64qyt6za/GSGSmartiecar/schematics/ReadMe.md

This directory contains schematics of the chassis and the electronics.
