64qyt6za/GSGSmartiecar/src/py/images/README.md

## Image description

## Frame image
the first image called frame.jpg is the normal raw version without anything uncut and unedited.

## Cropped image
the second image called cropped.jpg is the cropped version of the image. This image is cropped to the size of the frame of the image. This is done to remove the black borders around the image.
