64qyt6za/GSGSmartiecar/Carphotos/Below.jpg

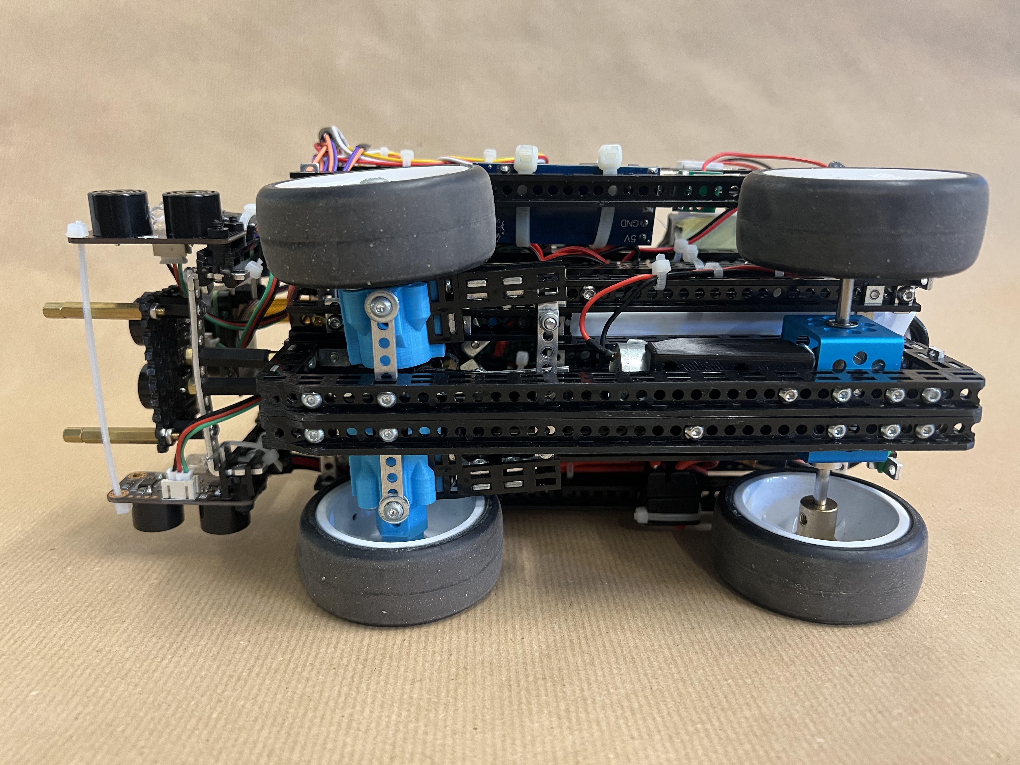
Carphotos/Below.jpg
