64qyt6za/GSGSmartiecar/Carphotos/Detailphotos/All-levels.jpg

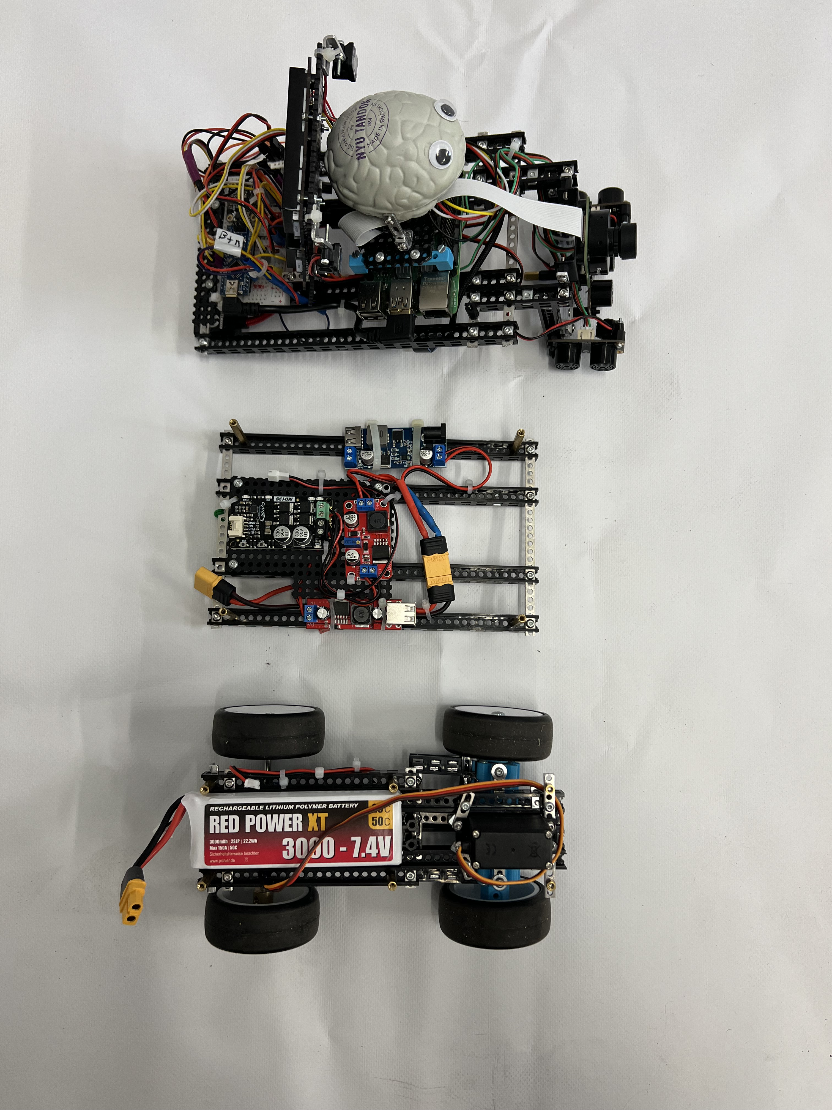
Carphotos/Detailphotos/All-levels.jpg
