64qyt6za/GSGSmartiecar/Carphotos/Detailphotos/First-level.jpg

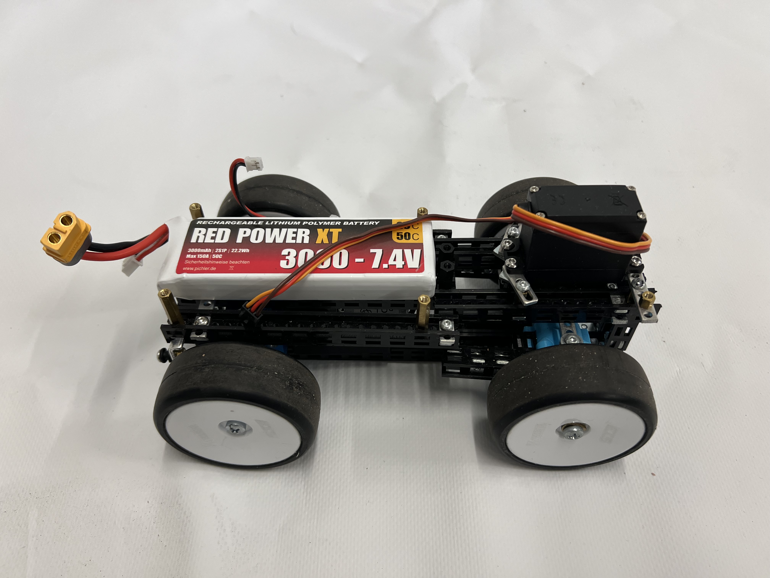
Carphotos/Detailphotos/First-level.jpg
