64qyt6za/GSGSmartiecar/Carphotos/Detailphotos/IMG_7283.jpeg

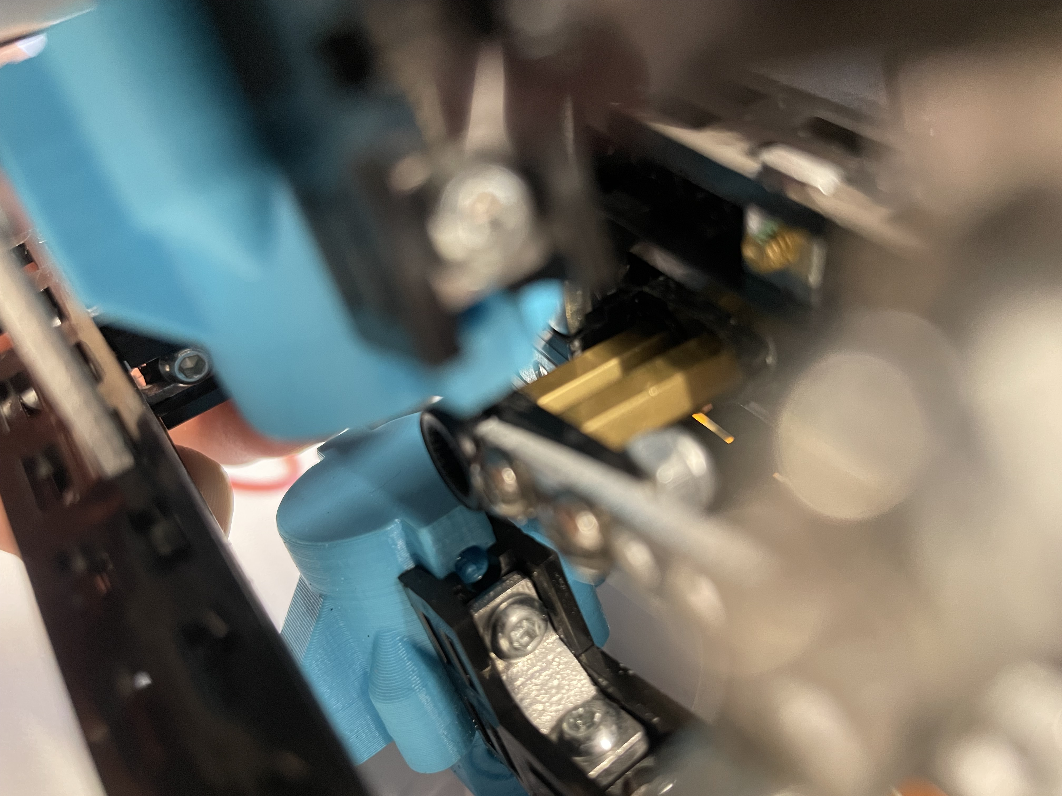
Carphotos/Detailphotos/IMG_7283.jpeg
