64qyt6za/GSGSmartiecar/Carphotos/Detailphotos/Second-level.jpg

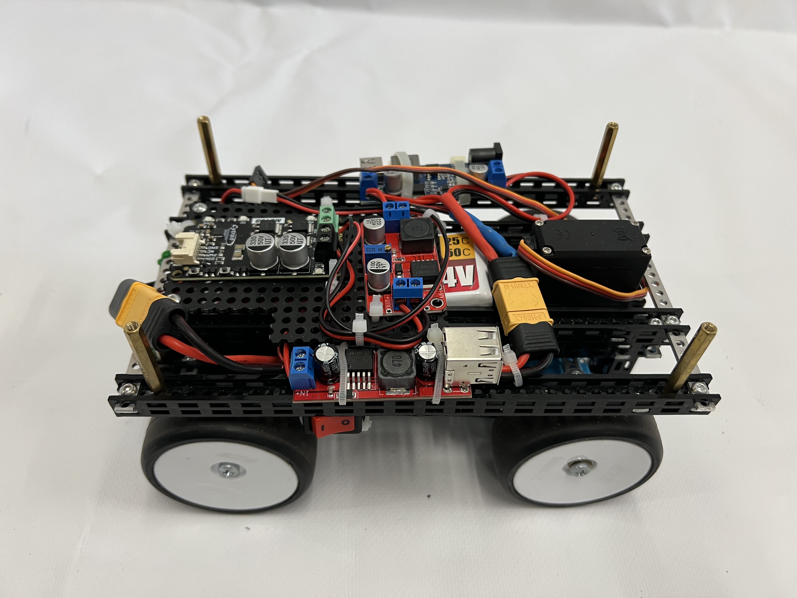
Carphotos/Detailphotos/Second-level.jpg
