64qyt6za/GSGSmartiecar/Carphotos/Detailphotos/Third-level.jpg

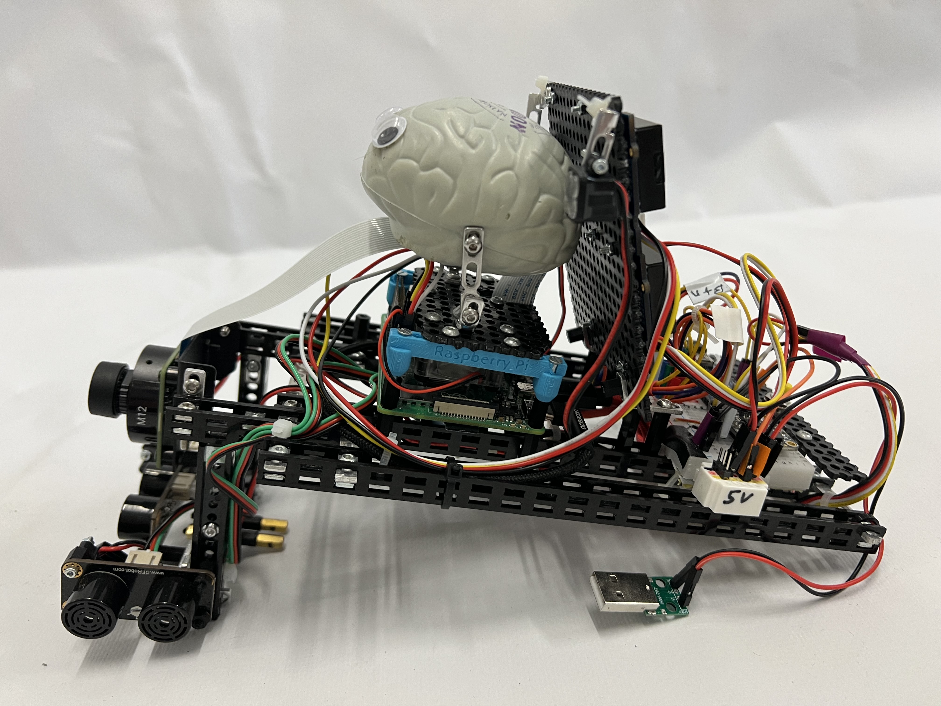
Carphotos/Detailphotos/Third-level.jpg
