64qyt6za/GSGSmartiecar/Carphotos/Detailphotos/Transmisson.jpg

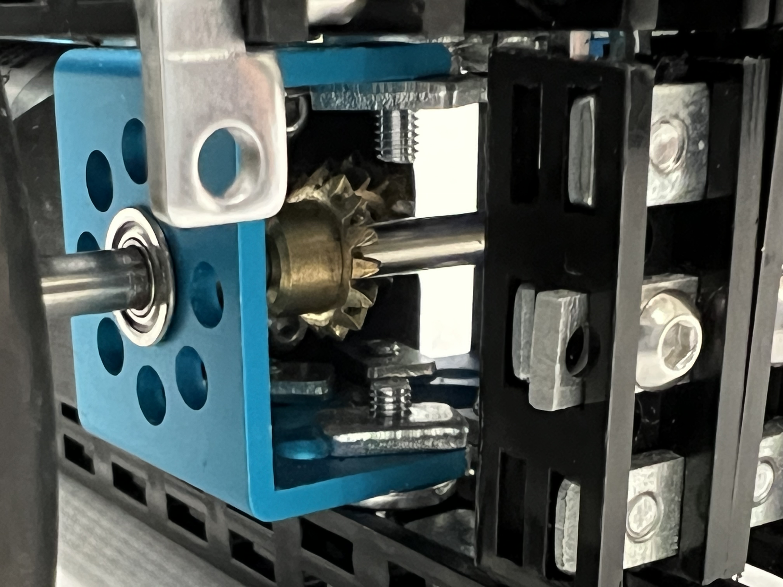
Carphotos/Detailphotos/Transmisson.jpg
