64qyt6za/GSGSmartiecar/schematics/Blockdiagram_layers.png

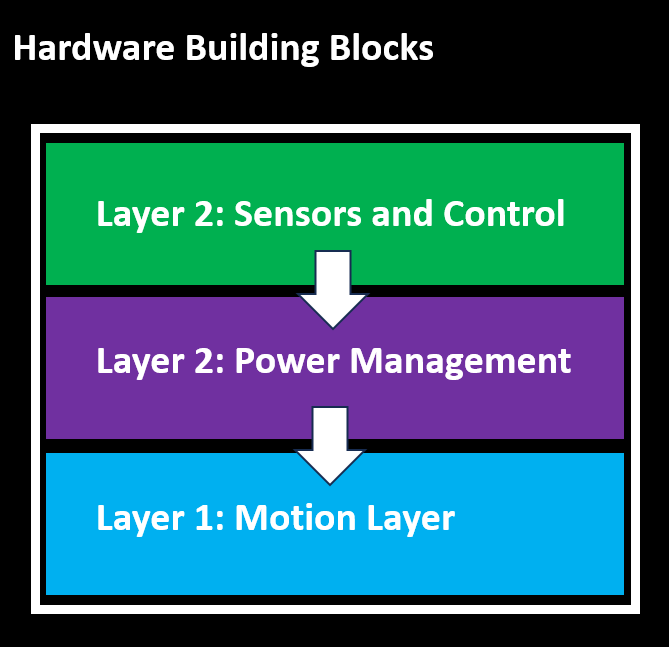
schematics/Blockdiagram_layers.png
