64qyt6za/GSGSmartiecar/schematics/blockdiagram_software.png

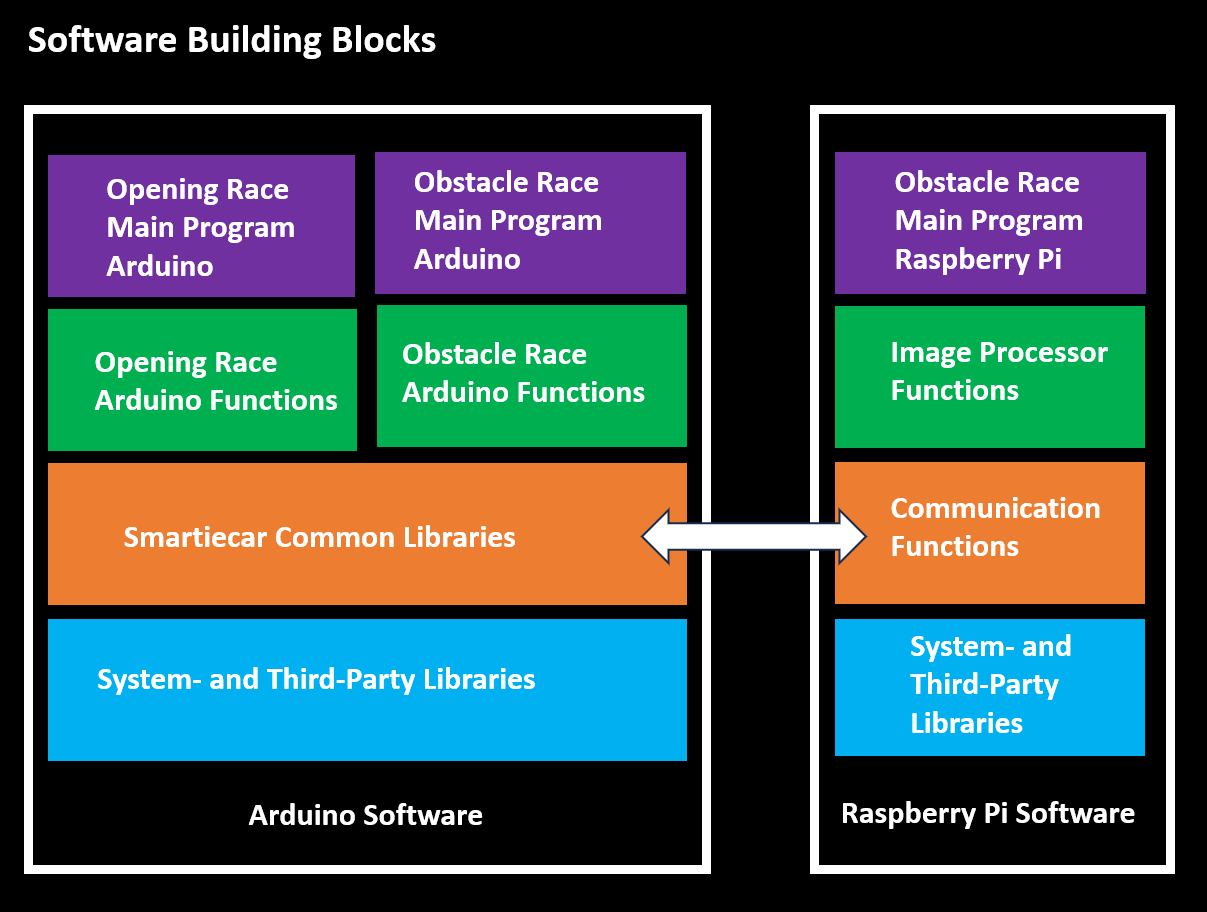
schematics/blockdiagram_software.png
