64qyt6za/GSGSmartiecar/schematics/circuit diagram3.jpg

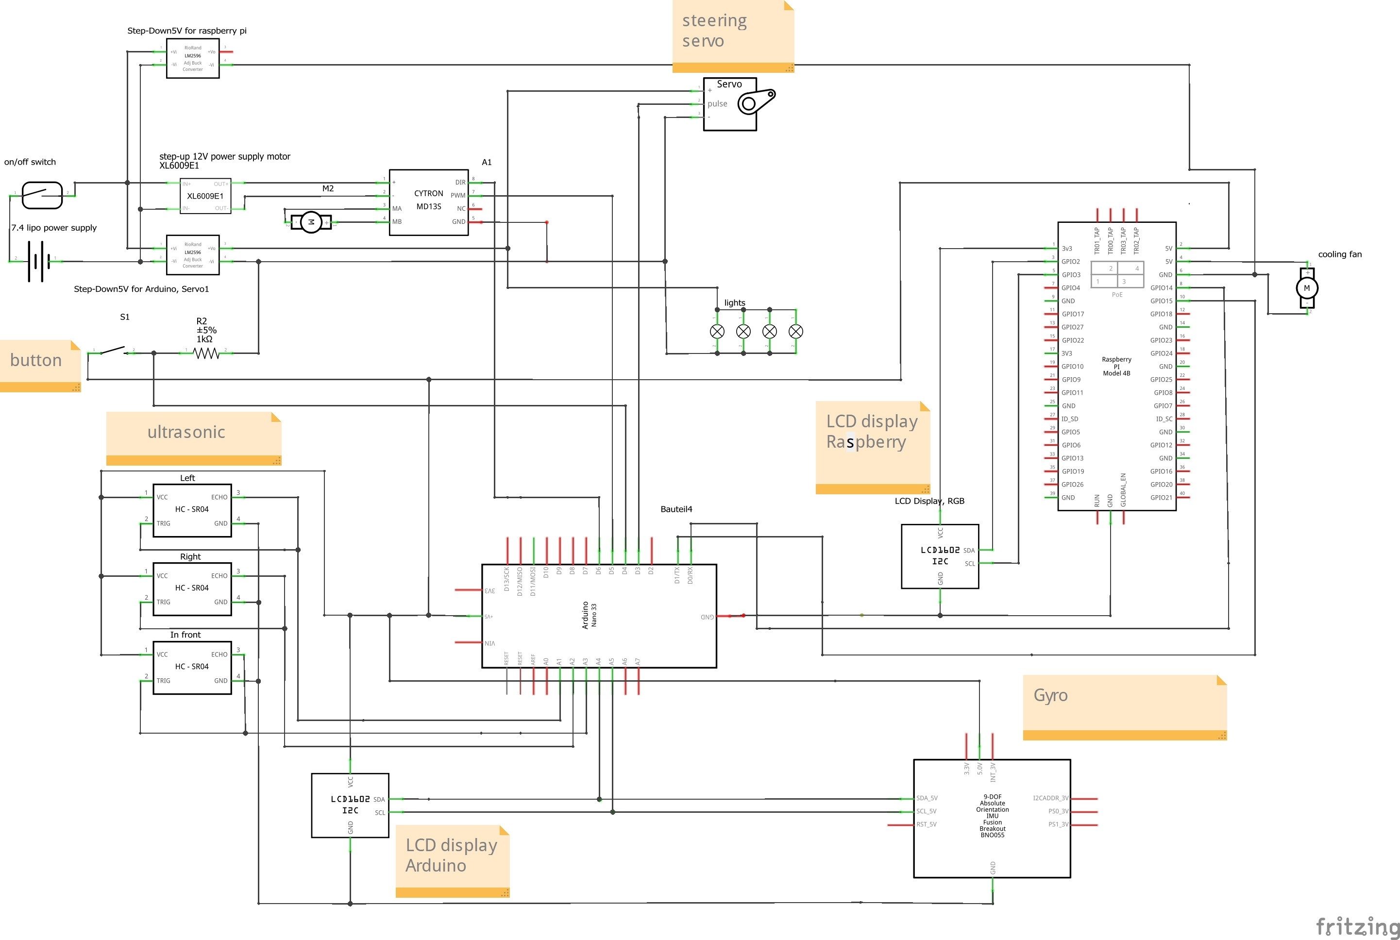
schematics/circuit diagram3.jpg
