64qyt6za/GSGSmartiecar/schematics/Layer 1 Side.png

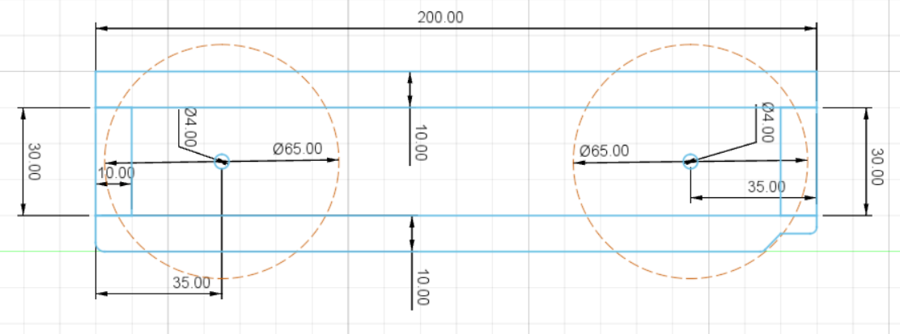
schematics/Layer 1 Side.png
