64qyt6za/GSGSmartiecar/schematics/Layer 1 Top.png

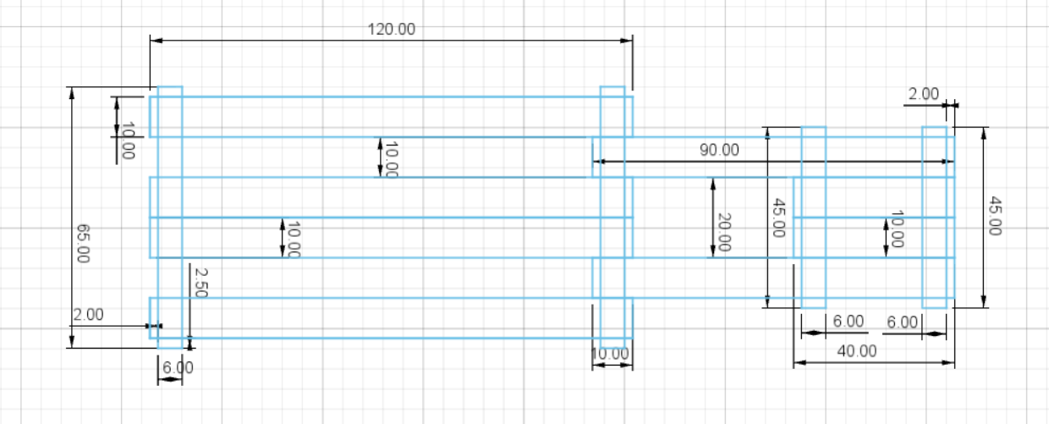
schematics/Layer 1 Top.png
