64qyt6za/GSGSmartiecar/schematics/Layer 2.png

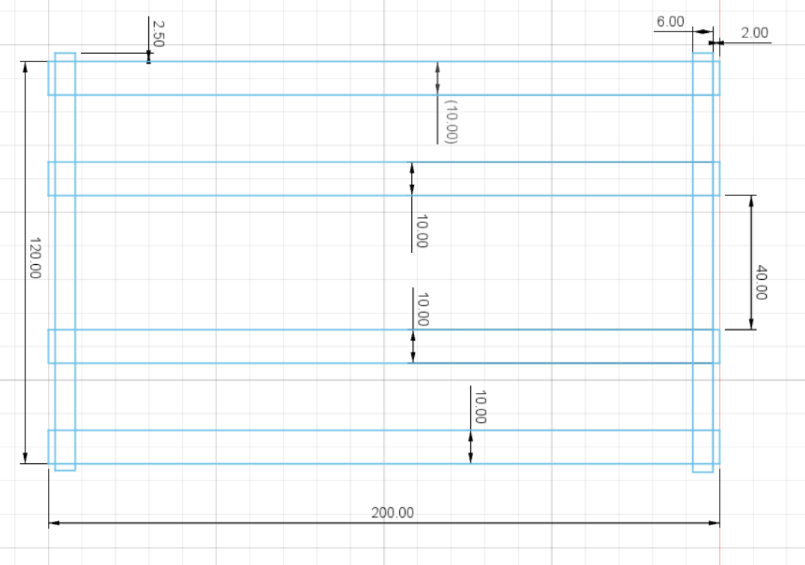
schematics/Layer 2.png
