64qyt6za/GSGSmartiecar/schematics/Layer 3 .png

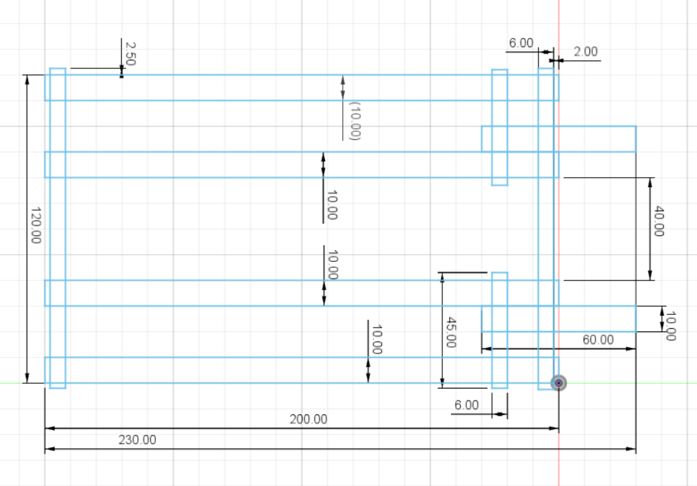
schematics/Layer 3 .png
