64qyt6za/GSGSmartiecar/src/ino/flow charts/Diagram_obstacle_init_phase.jpg

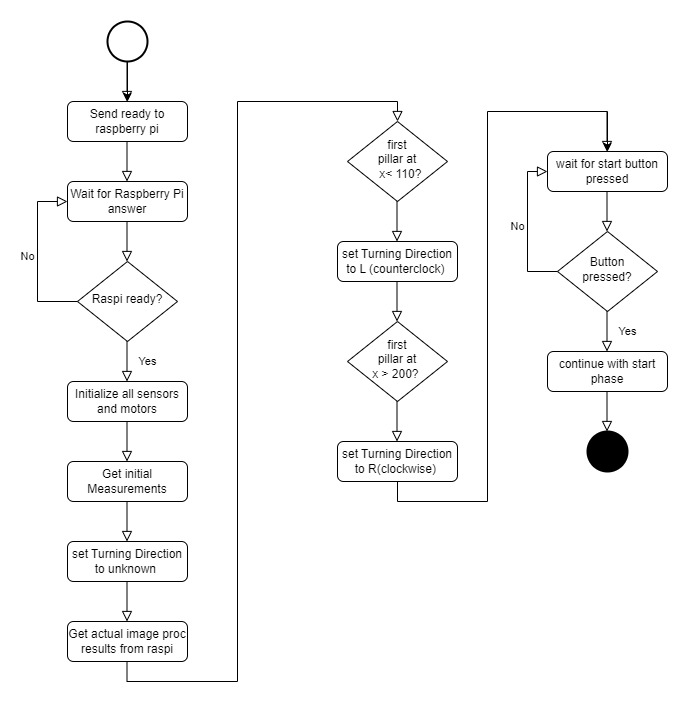
src/ino/flow charts/Diagram_obstacle_init_phase.jpg
