64qyt6za/GSGSmartiecar/src/ino/flow charts/Diagram_open_end_phase.jpg

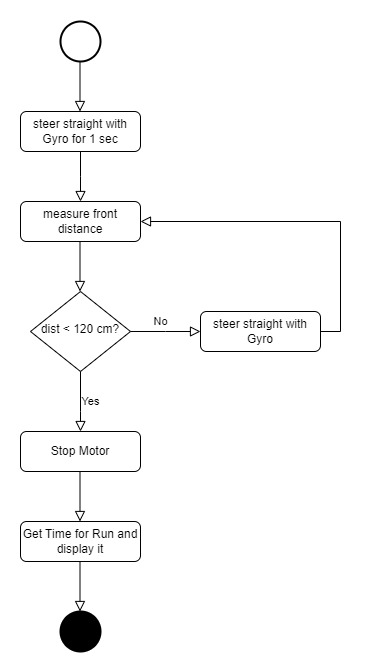
src/ino/flow charts/Diagram_open_end_phase.jpg
