64qyt6za/GSGSmartiecar/src/ino/flow charts/Diagram_open_phases.jpg

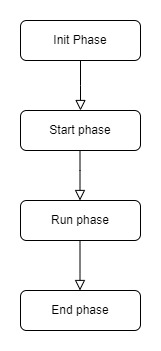
src/ino/flow charts/Diagram_open_phases.jpg
