64qyt6za/GSGSmartiecar/src/ino/flow charts/Diagram_open_start_phase.jpg

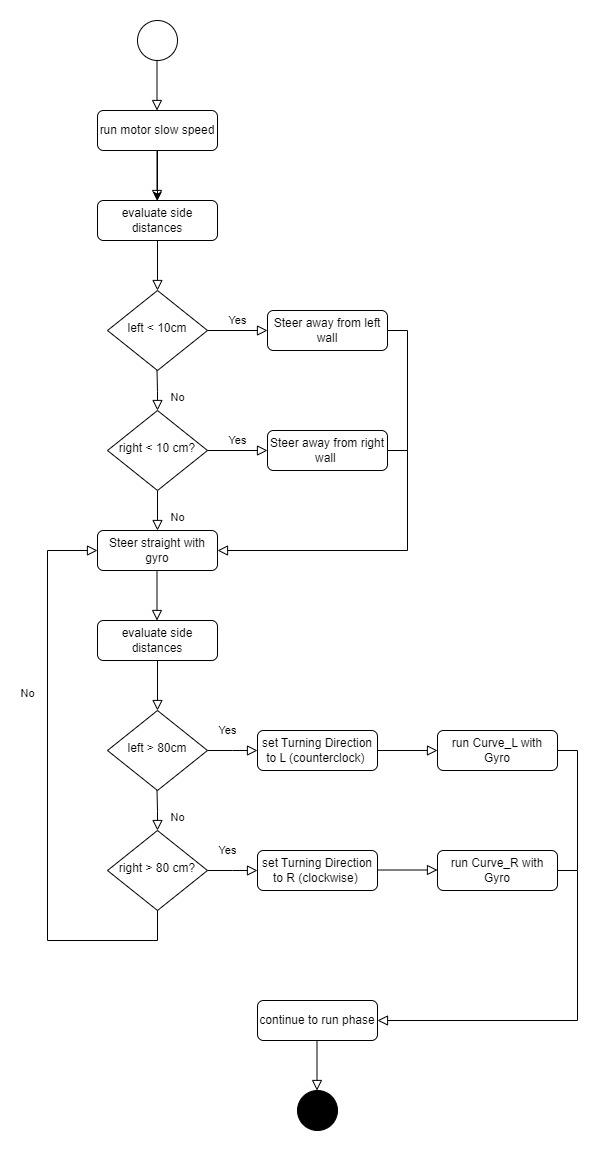
src/ino/flow charts/Diagram_open_start_phase.jpg
