64qyt6za/GSGSmartiecar/src/ino/flow charts/pillar_detector.jpg

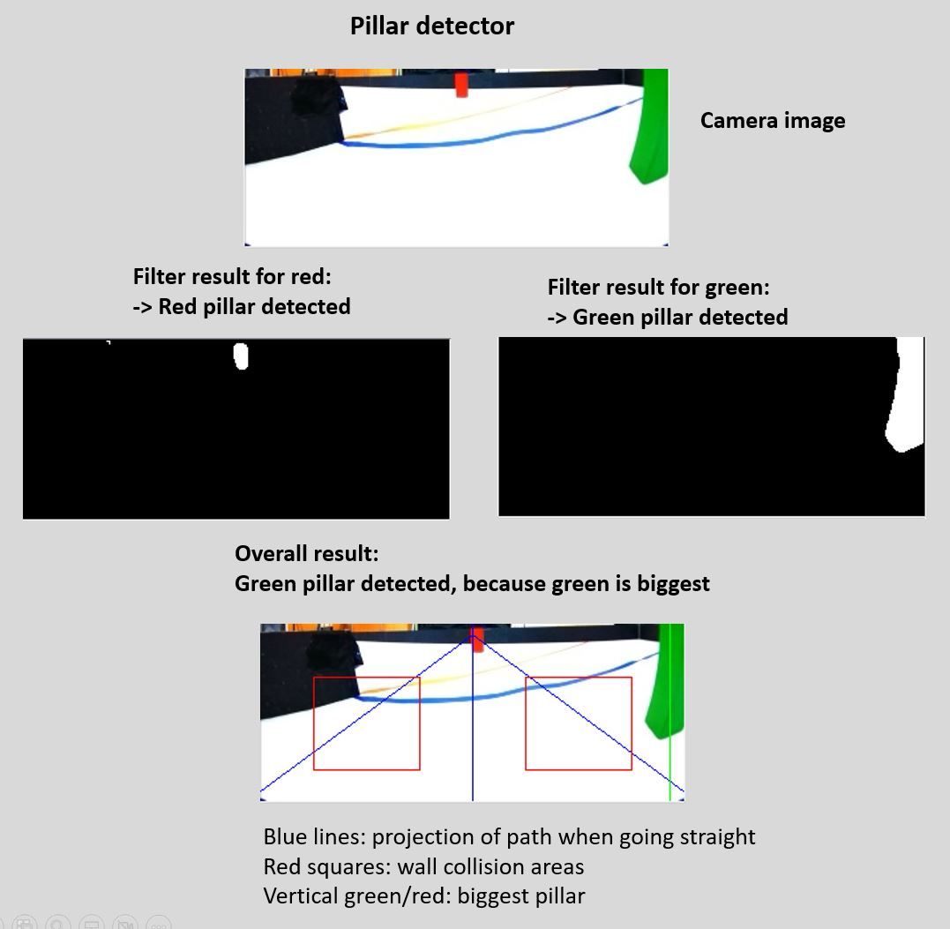
src/ino/flow charts/pillar_detector.jpg
