64qyt6za/GSGSmartiecar/src/ino/flow charts/Raspberry_Pi_detect_pillars.jpg

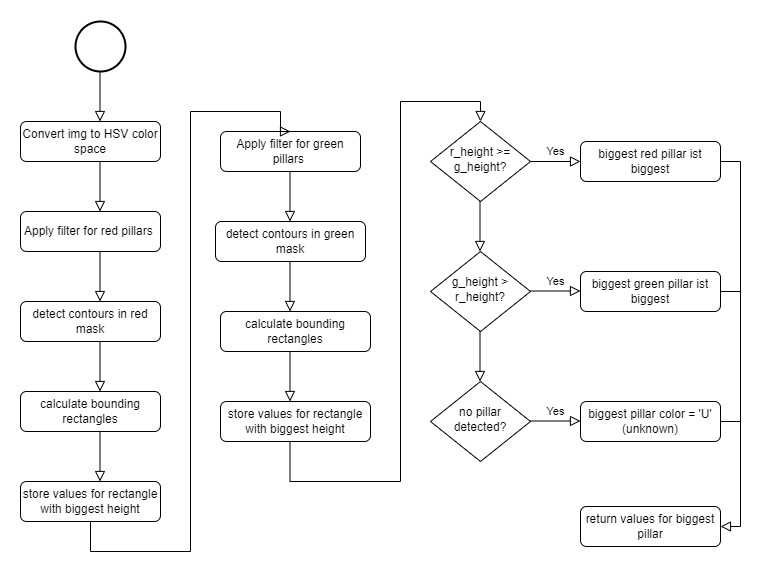
src/ino/flow charts/Raspberry_Pi_detect_pillars.jpg
