64qyt6za/GSGSmartiecar/src/ino/flow charts/Raspberry_Pi_main_run.jpg

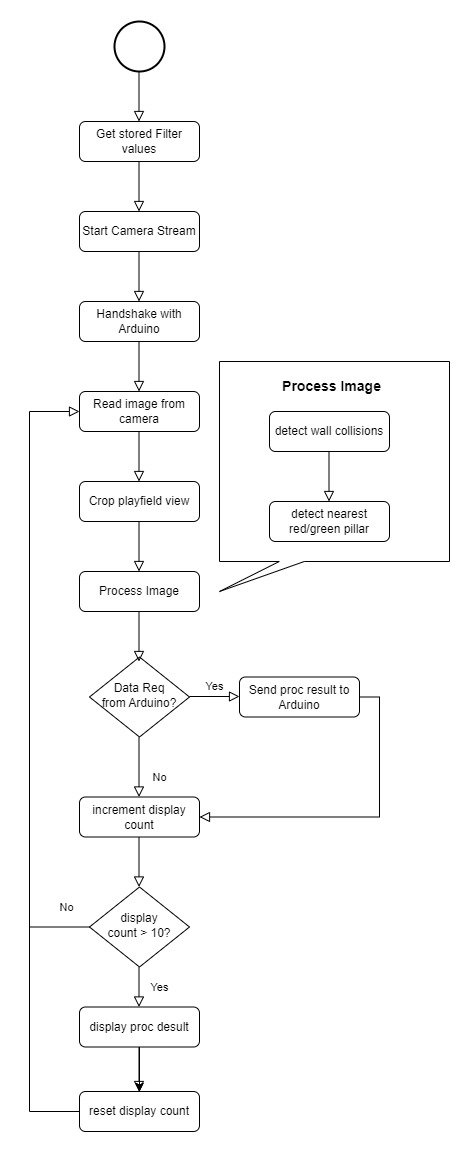
src/ino/flow charts/Raspberry_Pi_main_run.jpg
