64qyt6za/GSGSmartiecar/src/py/blobtest/blobs_b01.jpg

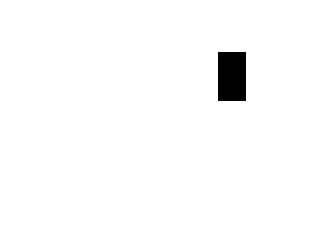
src/py/blobtest/blobs_b01.jpg
