64qyt6za/GSGSmartiecar/src/py/blobtest/blobs_b02.jpg

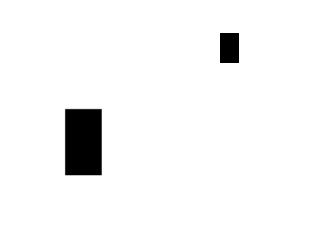
src/py/blobtest/blobs_b02.jpg
