64qyt6za/GSGSmartiecar/src/py/blobtest/blobs_c01.jpg

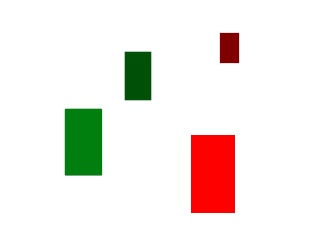
src/py/blobtest/blobs_c01.jpg
