64qyt6za/GSGSmartiecar/src/py/blobtest/blobs_c02.jpg

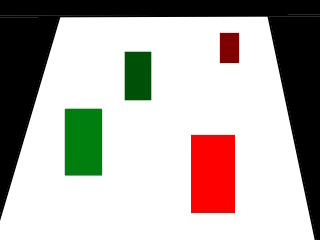
src/py/blobtest/blobs_c02.jpg
