64qyt6za/GSGSmartiecar/src/py/blobtest/blobs_w01.jpg

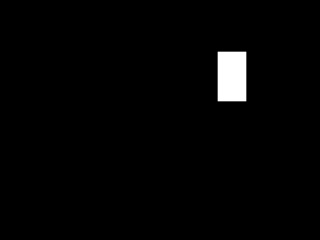
src/py/blobtest/blobs_w01.jpg
