64qyt6za/GSGSmartiecar/src/py/blobtest/blobs_w02.jpg

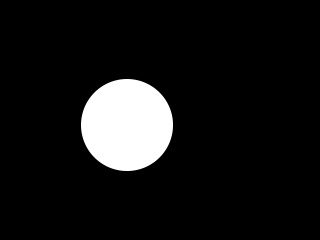
src/py/blobtest/blobs_w02.jpg
