64qyt6za/GSGSmartiecar/src/py/images/frame.jpg

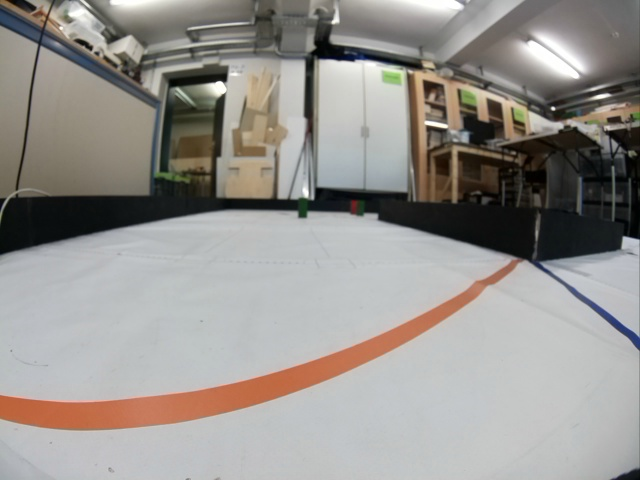
src/py/images/frame.jpg
