64qyt6za/GSGSmartiecar/src/py/images/img.jpg

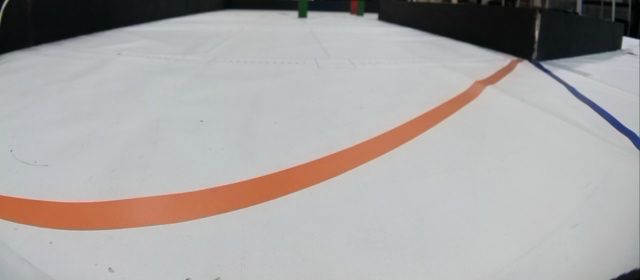
src/py/images/img.jpg
