64qyt6za/GSGSmartiecar/src/py/Tools/livestream.jpg

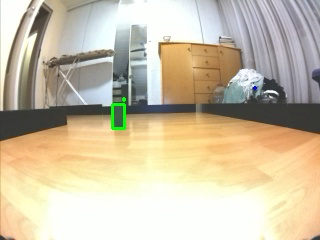
src/py/Tools/livestream.jpg
