64qyt6za/GSGSmartiecar/src/py/Tools/Path_mask.jpg

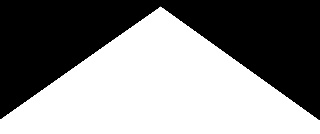
src/py/Tools/Path_mask.jpg
