64qyt6za/GSGSmartiecar/src/py/trackbars/optimal pi trackbar values.png

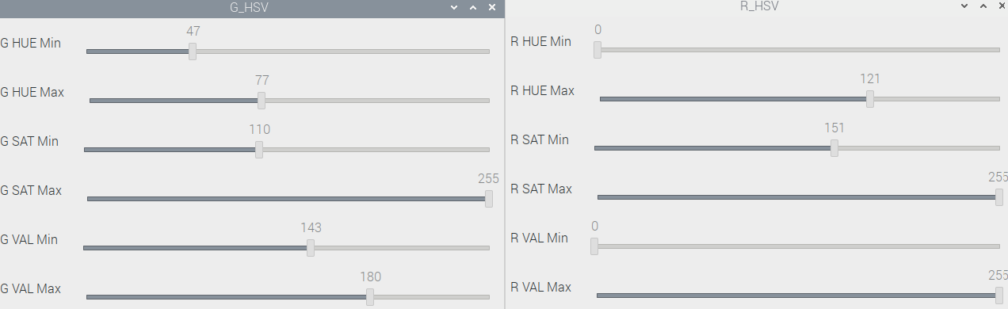
src/py/trackbars/optimal pi trackbar values.png
