64qyt6za/GSGSmartiecar/schematics/arduino_wiring.png

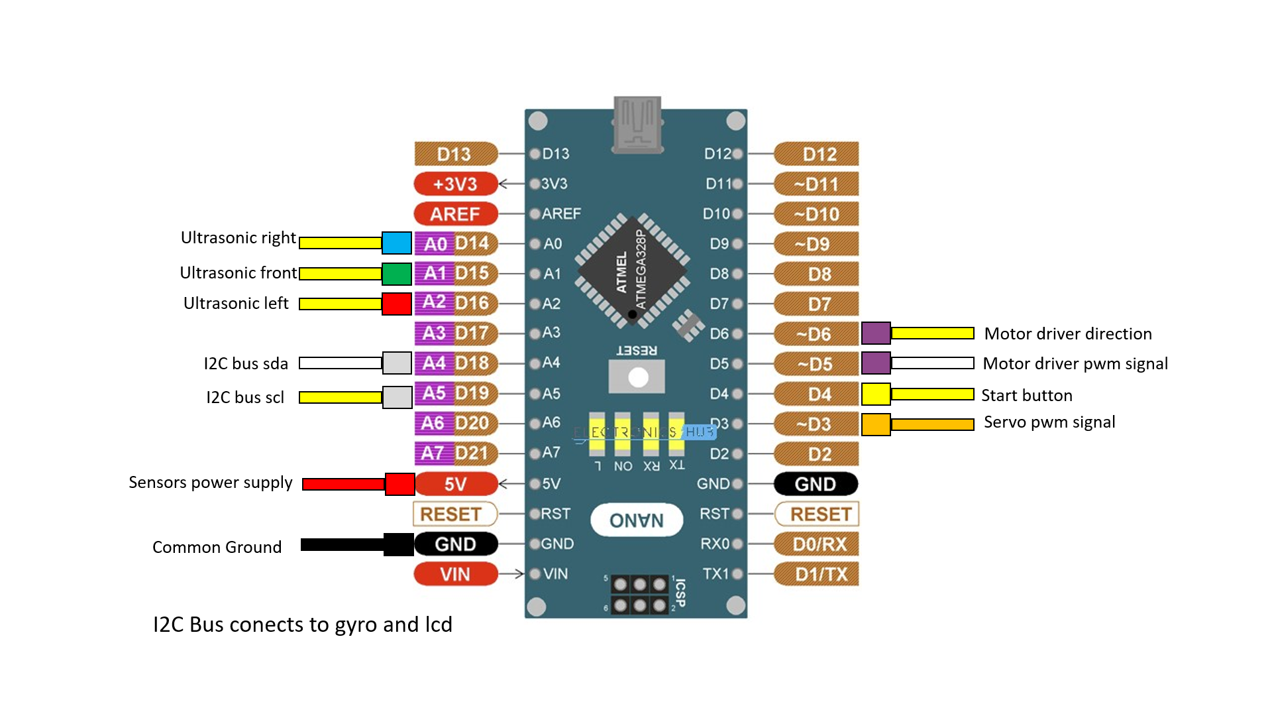
schematics/arduino_wiring.png
