64qyt6za/GSGSmartiecar/src/ino/Test Programs/gyro/gyro.ino

// Required libraries

#include "rgb_lcd.h"
#include "C:\Users\WRO_FE2\Desktop\GSG_SmartiecarV2\src\ino\smartiecar_libs\gyro2.h"

void setup()
{
    // lcd obj
    rgb_lcd lcd;
    lcd.begin(16, 2);

    // Set the color of the lcd
    lcd.setRGB(255, 255, 255);

    // Initialize and calibrate the gyroscope
    startGyroscope();
}

void loop()
{
    rgb_lcd lcd;
    // get the angle from the IMU
    float angle = IMU_getAngle();
    // Display the angle on the LCD
    lcd.setCursor(0, 0);
    lcd.print("Angle: ");
    lcd.print(angle);
    lcd.print("   ");
}
